hakubou/Tsukibito-StackChan/cad/reference/takao/README.md

# ｽﾀｯｸﾁｬﾝ タカオ版（SCS0009 用）3D モデル

出典: [mongonta0716/3DPrinter_Models](https://github.com/mongonta0716/3DPrinter_Models)（コミット `8bc1629`）
作者: タカオ（@mongonta555）さん / ライセンス: Apache 2.0（[LICENSE](LICENSE)）

| ファイル | 部品 | 数 | 備考 |
|---|---|---|---|
| `stackchan_takao_shell_v2_scs0009.stl` | シェル | 1 | **最初に試し刷りして CoreS3 がはまるか確認** |
| `stackchan_takao_bracket_v2.8_scs0009.stl` | ブラケット | 1 | サーボ 2 個と中継基板（25×27mm 以内）を収める |
| `stackchan_takao_feet_scs0009.stl` | 足 | 1 | |
| `stackchan_takao_feet_scs0009.2.with_legohole.stl` | 足（LEGO 穴付き） | 1 | 上の足の代わりに使う。LEGO 穴のない面を下にして印刷 |
| `stackchan_takao_hat_cat_CoreS3.stl` | 猫耳 HAT（CoreS3 用） | 1 | 任意。元は SG90 版のフォルダにあるが、サーボの種類に関係なく使える |

印刷: PLA、サポートはビルドプレートからのみ（作者推奨）。
もとは Core2 用の設計で「寸法はギリギリ」とのことなので、合わない部分は後加工や修正が必要になる場合がある。
