hakubou/Tsukibito-StackChan/cad/heian/stl/fuzukue_top.stl

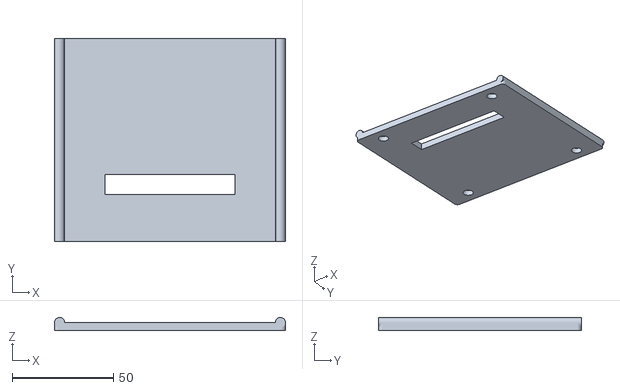
[picture p8: CAD file, 2026-11-12]
cad/heian/stl/fuzukue_top.stl
114.0 x 100.0 x 6.50
