hakubou/Tsukibito-StackChan/cad/reference/takao/stackchan_takao_feet_scs0009.2.with_legohole.stl

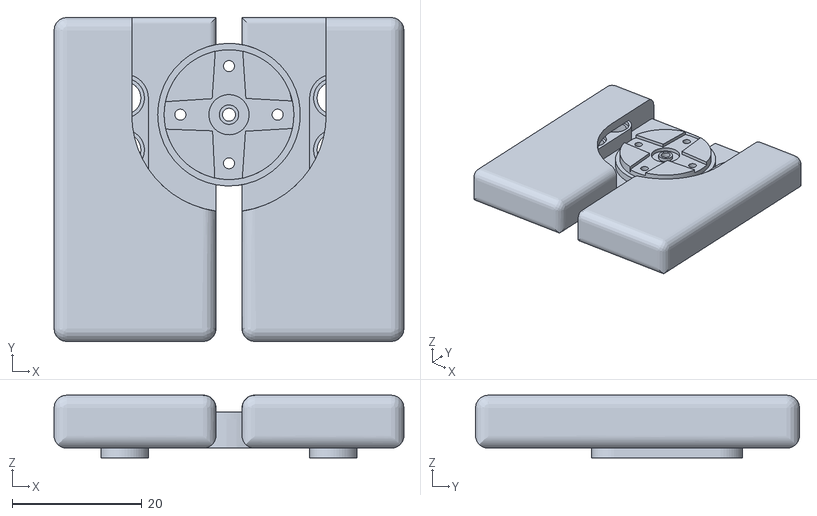
[picture p9: CAD file, 2026-11-11]
cad/reference/takao/stackchan_takao_feet_scs0009.2.with_legohole.stl
54.0 x 50.0 x 9.70
