hakubou/Tsukibito-StackChan/cad/heian/stl/dodai_tube.stl

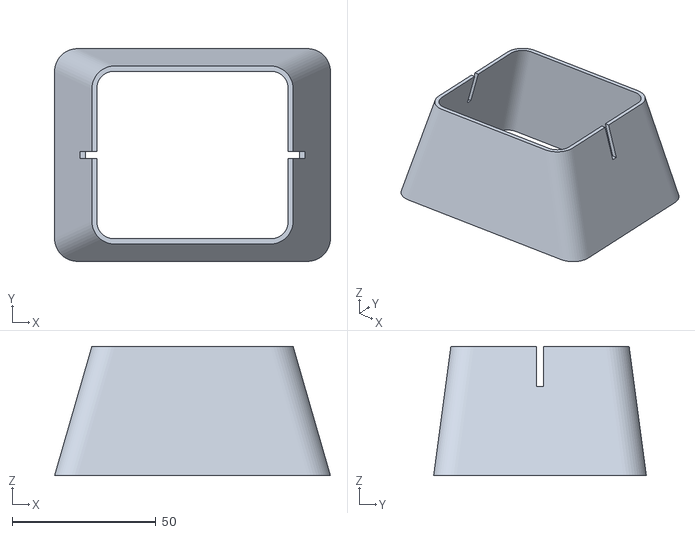
[picture p10: CAD file, 2026-11-12]
cad/heian/stl/dodai_tube.stl
96.0 x 74.0 x 45.0
