hakubou/Tsukibito-StackChan/cad/reference/takao/stackchan_takao_hat_cat_CoreS3.stl

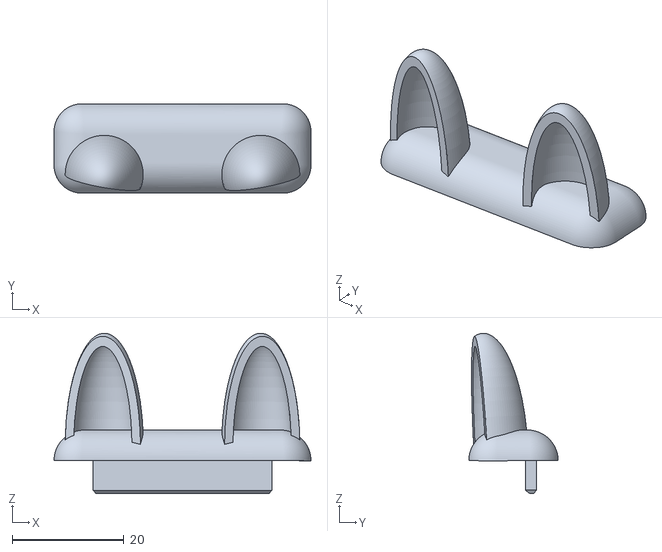
[picture p11: CAD file, 2026-11-11]
cad/reference/takao/stackchan_takao_hat_cat_CoreS3.stl
46.0 x 16.0 x 28.7
