hakubou/Tsukibito-StackChan/cad/heian/stl/eboshi_shell.stl

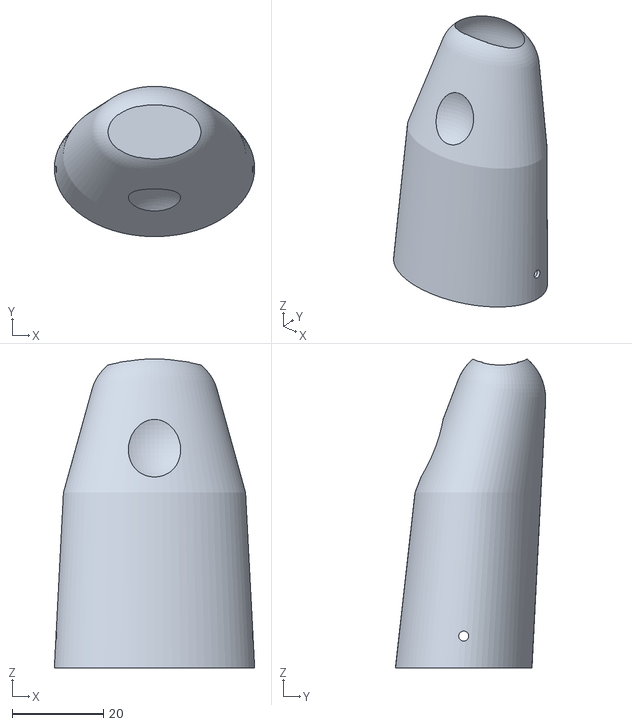
[picture p12: CAD file, 2026-11-12]
cad/heian/stl/eboshi_shell.stl
44.0 x 33.0 x 67.8
