hakubou/Tsukibito-StackChan/cad/reference/takao/stackchan_takao_feet_scs0009.stl

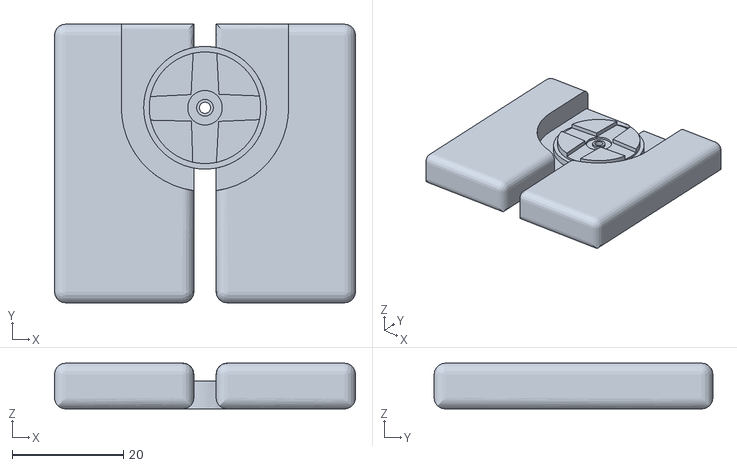
[picture p13: CAD file, 2026-11-11]
cad/reference/takao/stackchan_takao_feet_scs0009.stl
54.0 x 50.0 x 8.20
