hakubou/Tsukibito-StackChan/cad/heian/stl/eboshi_clip.stl

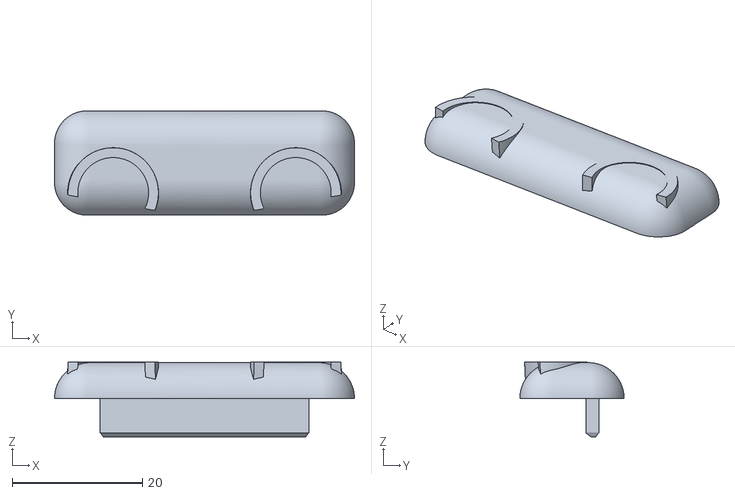
[picture p14: CAD file, 2026-11-12]
cad/heian/stl/eboshi_clip.stl
46.0 x 16.0 x 11.5
