hakubou/Tsukibito-StackChan/cad/reference/takao/stackchan_takao_shell_v2_scs0009.stl

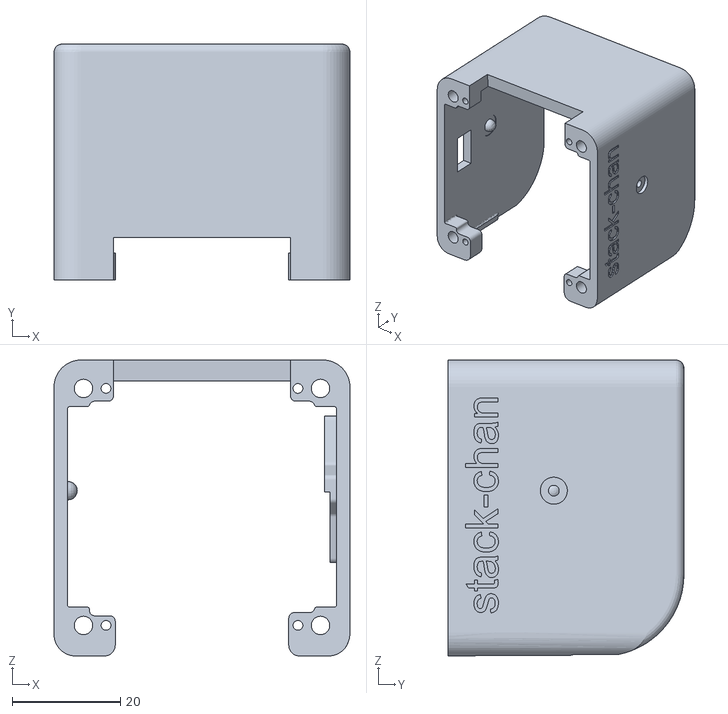
[picture p15: CAD file, 2026-11-11]
cad/reference/takao/stackchan_takao_shell_v2_scs0009.stl
54.6 x 43.5 x 54.6
