hakubou/Tsukibito-StackChan/cad/heian/stl/dodai_plate.stl

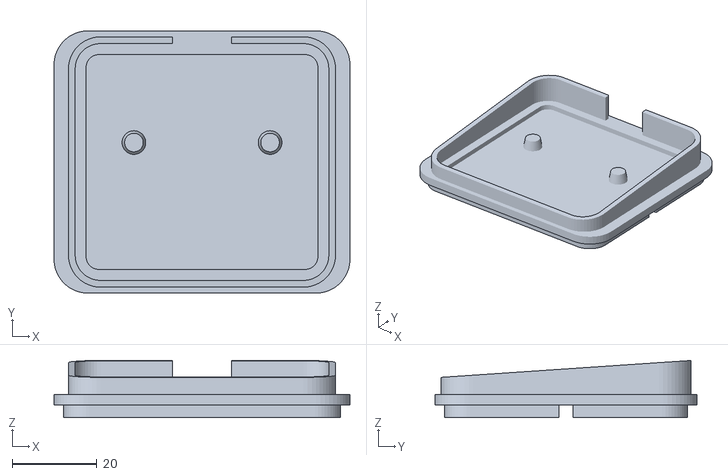
[picture p16: CAD file, 2026-11-12]
cad/heian/stl/dodai_plate.stl
70.0 x 62.0 x 13.5
