hakubou/Tsukibito-StackChan/cad/reference/takao/stackchan_takao_bracket_v2.8_scs0009.stl

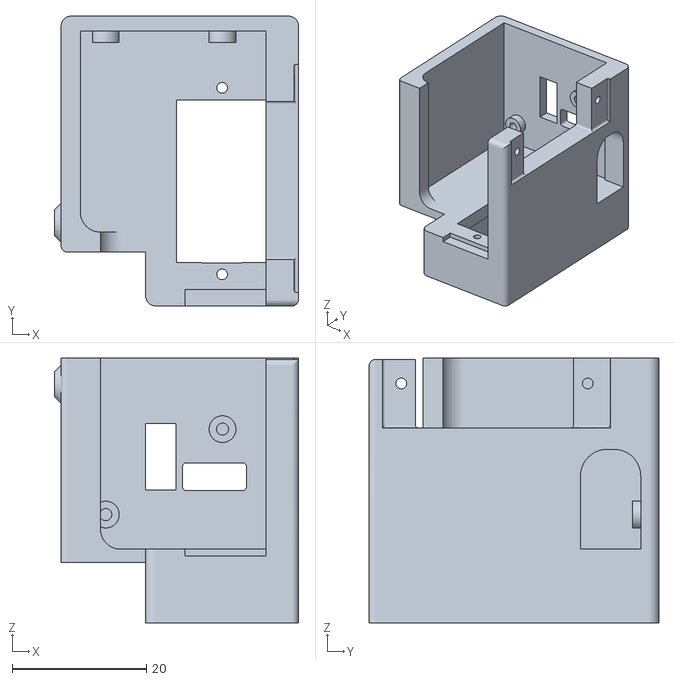
[picture p17: CAD file, 2026-11-11]
cad/reference/takao/stackchan_takao_bracket_v2.8_scs0009.stl
36.4 x 43.2 x 39.5
