hakubou/Tsukibito-StackChan/cad/heian/stl/byobu_rails.stl

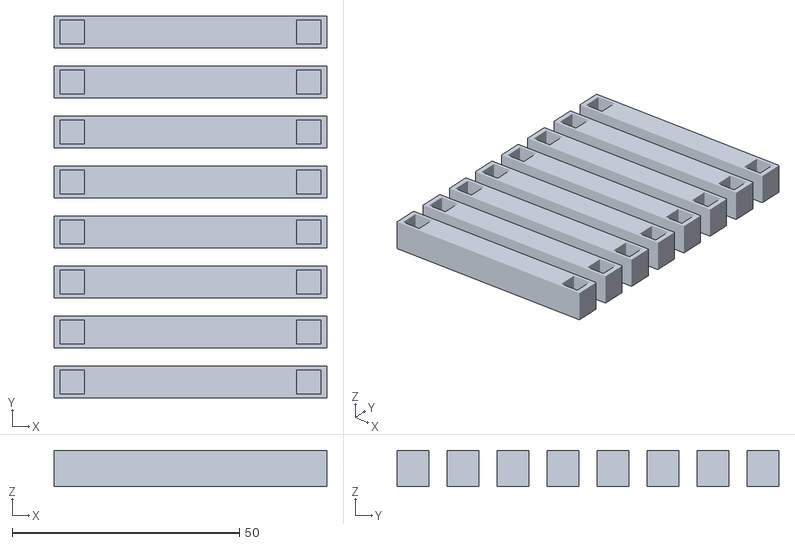
[picture p18: CAD file, 2026-11-12]
cad/heian/stl/byobu_rails.stl
60.0 x 84.0 x 8.00
