hakubou/Tsukibito-StackChan/cad/heian/stl/komono.stl

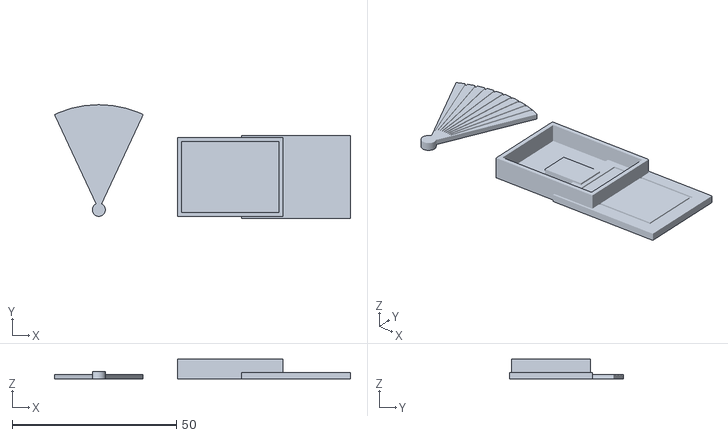
[picture p19: CAD file, 2026-11-12]
cad/heian/stl/komono.stl
90.1 x 34.6 x 6.00
