hakubou/Tsukibito-StackChan/cad/heian/stl/fuzukue_body.stl

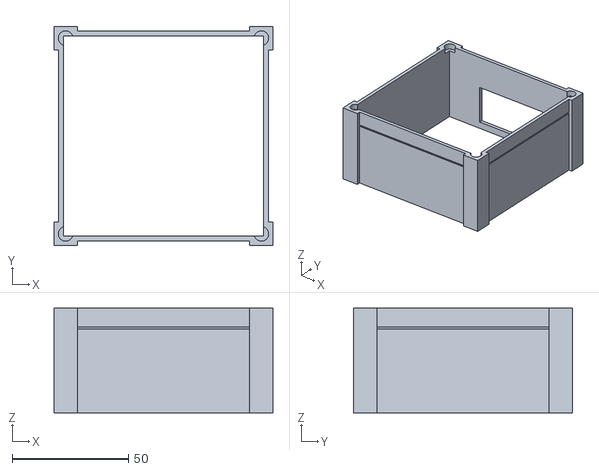
[picture p20: CAD file, 2026-11-12]
cad/heian/stl/fuzukue_body.stl
94.0 x 94.0 x 45.0
