hakubou/Tsukibito-StackChan/cad/heian/stl/tatami_robot.stl

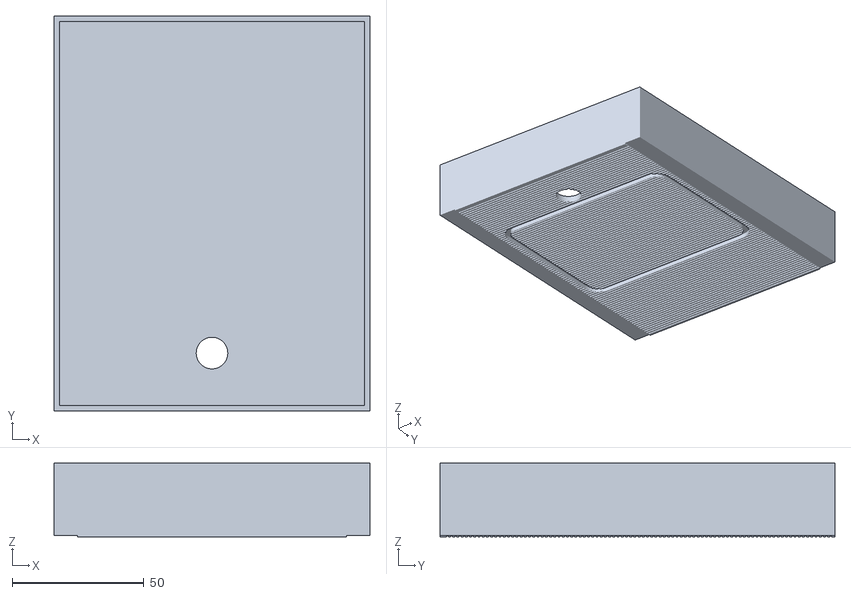
[picture p21: CAD file, 2026-11-12]
cad/heian/stl/tatami_robot.stl
120.0 x 150.0 x 28.0
