hakubou/Tsukibito-StackChan/cad/heian/stl/sleeve_l.stl

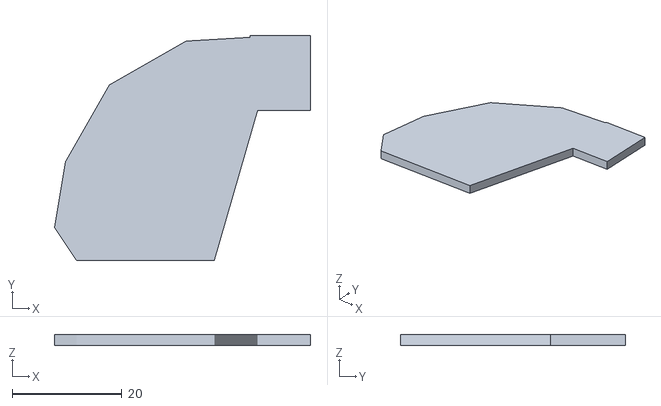
[picture p22: CAD file, 2026-11-12]
cad/heian/stl/sleeve_l.stl
46.7 x 41.0 x 2.00
