hakubou/Tsukibito-StackChan/(list of files, cad)

Other CAD files:
cad/heian/stl/tatami_desk.stl
cad/heian/stl/sleeve_r.stl
