hakubou/Tsukibito-StackChan/cad/heian/preview/assembly_side.png

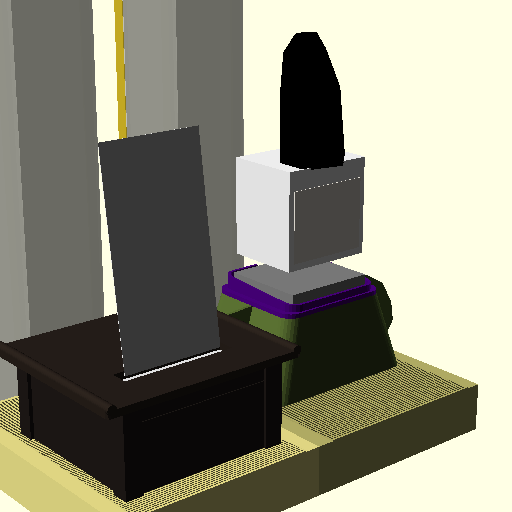
cad/heian/preview/assembly_side.png
