hakubou/Tsukibito-StackChan/(commit log)

2026-11-11 平安俳句ｽﾀｯｸﾁｬﾝの構想・装飾設計とファームウェアの土台を追加
    [stackchan_takao_bracket_v2.8_scs0009.stl, stackchan_takao_feet_scs0009.2.with_legohole.stl, stackchan_takao_feet_scs0009.stl, stackchan_takao_hat_cat_CoreS3.stl, stackchan_takao_shell_v2_scs0009.stl]
2026-11-11 平安顔のAvatarとずんだもんボイス（口パク付き）を追加
    - HeianFace.h: 引目鉤鼻・置眉・紅の口・頬紅の顔パーツ（16bitカラー）
    - tools/gen_voices.py: VOICEVOXでセリフを生成しファームウェアに埋め込む
    - タッチでセリフを順に再生、音量に合わせて口パク
2026-11-12 吹き出しを削除し、3Dプリント＋布の筐体設計を追加
    - main.cpp: 吹き出し（字幕）を表示しないように変更
    - cad/heian: 烏帽子・胴台・畳台・文机・屏風・小物の OpenSCAD モデルと STL（A1 mini 対応）
    - docs/enclosure.md: 部品表・印刷設定・布の型紙・組み立て順
    [assembly.scad, byobu.scad, byobu_rails.stl, dodai.scad, dodai_plate.stl, dodai_tube.stl, eboshi.scad, eboshi_clip.stl]
2026-11-12 READMEに完成イメージを掲載
2026-11-12 屏風の枠を金色に戻す（紙は生成りのまま）
    [assembly.scad, byobu.scad]
2026-11-12 READMEに顔の画像を追加し、完成イメージを差し替え
    - 完成イメージを docs/images/concept.png に移動（キャッシュで旧画像が出るのを避けるため改名）
    - tools/render_face.py: HeianFace.h と同じ描画で顔と表情一覧の画像を生成
2026-11-12 接客のソフトウェア構成を追加（docs/software.md）
    - 客寄せ〜短冊の手渡しのステートマシン、モジュール構成、ゲーム連携API、スタッフ画面
    - 内蔵近接センサは数cmしか測れないため、来客検知は外付けセンサに訂正
2026-11-12 人の検知を内蔵カメラの顔検出だけで行う構成に変更
2026-11-12 S0: 内蔵カメラの顔検出と、平安顔の独自描画
    - FaceSensor.h: GC0308 + esp-dl の2段階顔検出を別タスク（コア0）で実行
    - HeianFace.h: M5Stack-Avatar をやめ、320x24 の帯をDMAで転送する描画に変更（8fps → 28fps）
    - 検出した顔の方へ瞳を向ける。2秒ごとに速度・検出結果をシリアルに出す
2026-11-12 声をちび式じいに変更、カメラ画像の取り出しと顔検出時の笑顔を追加
    - voice/phrases.json: VOICEVOX ちび式じい（話者42）、セリフをじい口調に
    - FaceSensor.h: シリアルに s でカメラ画像を1枚 base64 出力（デバッグ用・保存しない）
    - 顔を検出している間は笑顔になる（検出できているかを画面で確認できるように）
